jimbro1000/DragonATXProtoVDG/DragonATXProtoVDG.kicad_pcb

## KiCad design DragonATXProtoVDG.kicad_pcb (2025-12-16)

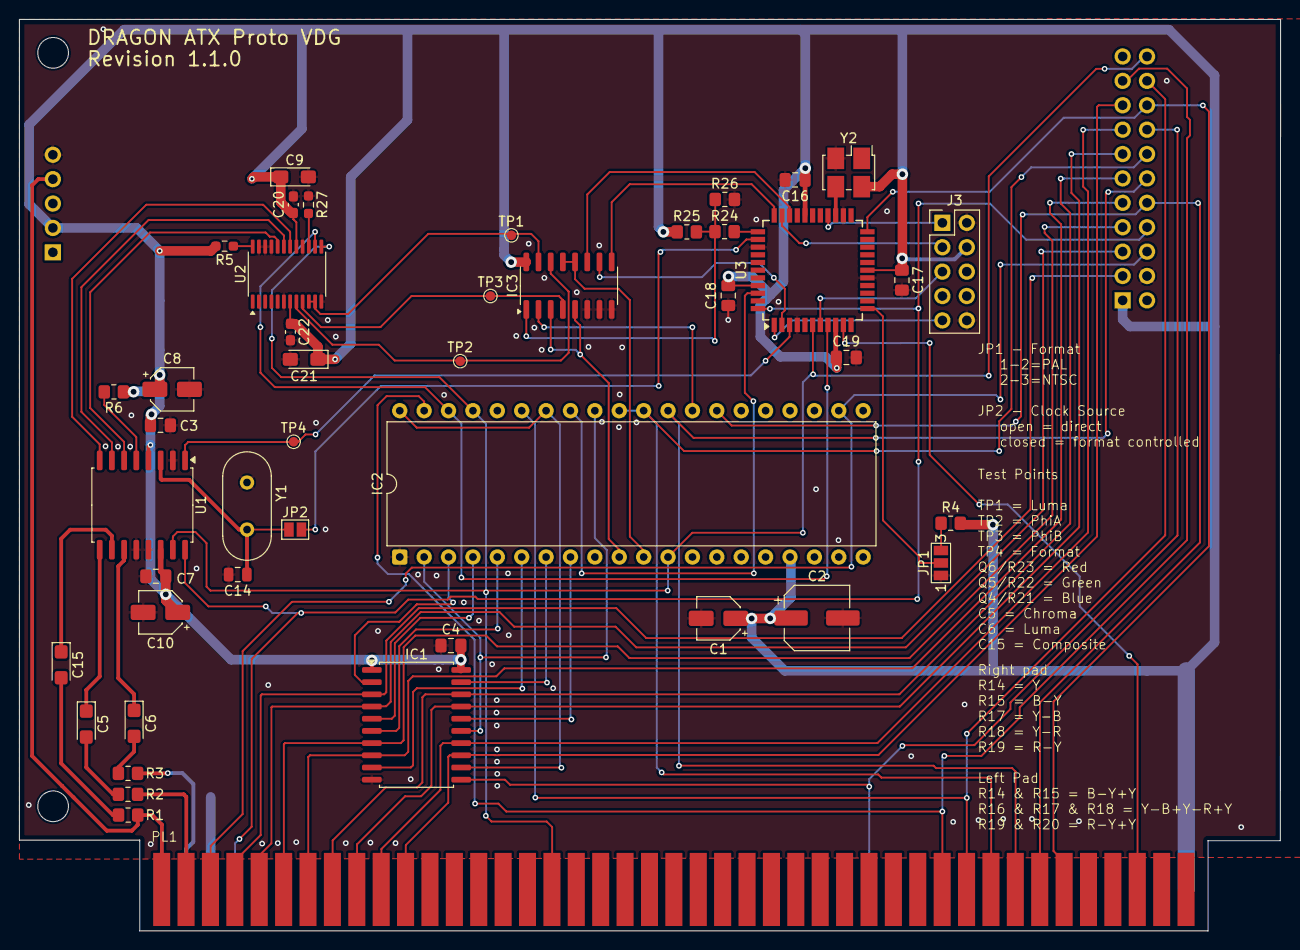
[picture p2: board DragonATXProtoVDG.kicad_pcb from above]

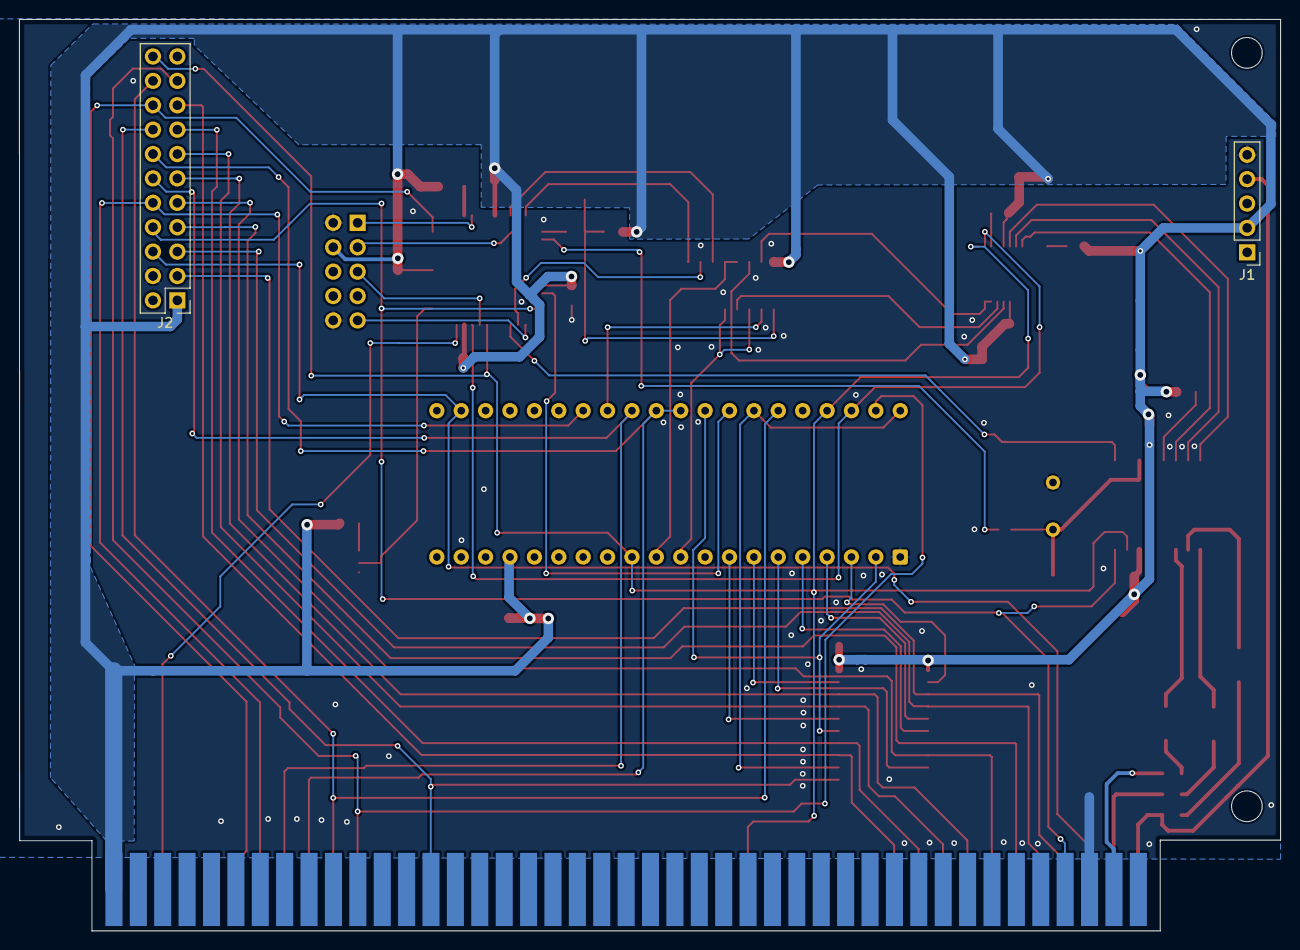
[picture p3: board DragonATXProtoVDG.kicad_pcb from below]

Board: 2 copper layers, 131.3 x 94.9 mm, 49 parts (2 on the bottom side), 67 nets.

Parts:
C1, C8, C10: 10uF; CP_Elec_4x5.4
C2: 100uF; CP_Elec_6.3x5.8
C3, C4, C7, C16, C17, C18, C19: 0.1uF; C_0805_2012Metric_Pad1.18x1.45mm_HandSolder
C5, C6, C15: 220uF; CP_EIA-3216-12_Kemet-S
C9, C21: 10uF; CP_EIA-3216-10_Kemet-I_Pad1.58x1.35mm_HandSolder
C14: 51pF; C_0805_2012Metric
C20, C22: 0.1uF; C_0603_1608Metric_Pad1.08x0.95mm_HandSolder
H1, H2: MountingHole; MountingHole_3.2mm_M3
IC1: 74LS273; SOIC-20W_7.5x12.8mm_P1.27mm
IC2: MC6847; DIP-40_W15.24mm
IC3: MC14053; SOIC-16_3.9x9.9mm_P1.27mm
J1: Video Output; PinHeader_1x05_P2.54mm_Vertical
J2: Board Interconnect Male; PinHeader_2x11_P2.54mm_Vertical
J3: JTAG; PinHeader_2x05_P2.54mm_Vertical
JP1: Video Format; SolderJumper-3_P1.3mm_Open_Pad1.0x1.5mm_NumberLabels
JP2: FormatClock; SolderJumper-2_P1.3mm_Open_Pad1.0x1.5mm
PL1: Card_Edge
R1, R2, R3: 75R; R_0805_2012Metric_Pad1.20x1.40mm_HandSolder
R4, R6: 10K; R_0805_2012Metric_Pad1.20x1.40mm_HandSolder
R5: 2k7; R_0603_1608Metric_Pad0.98x0.95mm_HandSolder
R24: 12K; R_0805_2012Metric_Pad1.20x1.40mm_HandSolder
R25: 8K2; R_0805_2012Metric_Pad1.20x1.40mm_HandSolder
R26: 1K8; R_0805_2012Metric_Pad1.20x1.40mm_HandSolder
R27: 10K; R_0603_1608Metric_Pad0.98x0.95mm_HandSolder
TP1: TestPoint_Luma; TestPoint_Pad_D1.0mm
TP2: TestPoint_PhiA; TestPoint_Pad_D1.0mm
TP3: TestPoint_PhiB; TestPoint_Pad_D1.0mm
TP4: TestPoint_FrameFormat; TestPoint_Pad_D1.0mm
U1: AD724JR; SOIC-16W_7.5x10.3mm_P1.27mm
U2: LMH1251; TSSOP-24_4.4x7.8mm_P0.65mm
U3: ATF1502ASL-xAx44; TQFP-44_10x10mm_P0.8mm
Y1: 4.433620MHz; Crystal_HC18-U_Vertical
Y2: 4.433618MHz; Oscillator_SMD_SeikoEpson_SG8002LB-4Pin_5.0x3.2mm_HandSolde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

Connections:
+5V: C1.1, C2.1, C3.1, C4.2, C7.2, C8.1, C9.1, C10.1, C16.1, C17.1, C18.1, C19.1, C20.2, C21.1, C22.1, IC1.1 (~Mr), IC1.20 (VCC), IC2.17 (VCC), IC3.16 (VDD), J1.2, J2.1, J3.4, PL1.b43, R4.2, R5.2, R6.1, R25.1, U1.4 (AVCC), U1.14 (DVCC), U2.7 (VCC), U2.17 (VCC), U3.9 (VCC), U3.17 (VCC), U3.29 (VCC), U3.41 (VCC), Y2.4 (Vdd)
/CSS: IC2.39 (CSS), J2.19, PL1.a33
/DA0: IC2.22 (DA0), J2.6, PL1.a3
/DL0: IC1.3 (D0), J2.3, PL1.a4
/DL1: IC1.4 (D1), J2.5, PL1.a5
/DL2: IC1.7 (D2), J2.7, PL1.a6
/DL3: IC1.8 (D3), J2.9, PL1.a7
/DL4: IC1.18 (D7), J2.11, PL1.a8
/DL5: IC1.17 (D6), J2.13, PL1.a9
/DL6: IC1.14 (D5), J2.15, PL1.a10
/DL7: IC1.13 (D4), J2.17, PL1.a11
/GM0: IC2.30 (GM0), IC2.31 (~INT/EXT), J2.14, PL1.a35
/GM1: IC2.29 (GM1), J2.12, PL1.a36
/GM2: IC2.27 (GM2), J2.10, PL1.a37
/HS: J2.8, PL1.b4, U1.16 (HSYNC), U3.44 (I/O)
/Q0: IC1.2 (Q0), IC2.3 (D0)
/Q1: IC1.5 (Q1), IC2.4 (D1)
/Q2: IC1.6 (Q2), IC2.5 (D2)
/Q3: IC1.9 (Q3), IC2.6 (D3)
/Q4: IC1.19 (Q7), IC2.7 (D4)
/Q5: IC1.16 (Q6), IC2.8 (D5)
/Q6: IC1.15 (Q5), IC2.2 (D6), IC2.32 (INV)
/Q7: IC1.12 (Q4), IC2.34 (~A/S), IC2.40 (D7)
/RAS: IC1.11 (Cp), J2.16, PL1.b30
/VCLK: J2.18, PL1.a38, U3.22 (I/O)
/~A/G: IC2.35 (~A/G), J2.20, PL1.a34
BLUE: U1.8 (BLUE), U2.18 (Bout)
CHROMA_CONTROL: IC3.9 (C), U3.33 (I/O)
CLK: IC2.33 (CLK), U3.42 (I/O)
Chroma: PL1.a2, R2.1
Composite: J1.4, PL1.a1, R1.1
E: PL1.a41, U3.10 (I/O)
FMT_CLOCK: JP2.2 (B), U3.35 (I/O/GCLK3)
Format: JP1.2 (C), U3.12 (I/O)
FrmFormat: TP4.1, U1.1 (NTSC/PAL), U3.3 (I/O)
GND: C1.2, C2.2, C3.2, C4.1, C7.1, C8.2, C9.2, C10.2, C14.2, C16.2, C17.2, C18.2, C19.2, C20.1, C21.2, C22.2, IC1.10 (GND), IC2.1 (GND), IC3.6 (INHIBIT), IC3.7 (VEE), IC3.8 (VSS), J1.5, J2.4, J3.2, J3.10, JP1.1 (A), PL1.b3, R26.2, R27.1, U1.2 (AGND), U1.12 (SELECT), U1.13 (DGND), U2.6 (GND), U2.12 (GND), U2.16 (GND), U2.21 (Sleep), U2.22 (SD/HD), U2.23 (AUTO), U3.4 (GND), U3.16 (GND), U3.24 (GND), U3.36 (GND), Y1.1, Y2.2 (GND)
GREEN: U1.7 (GREEN), U2.19 (Gout)
LUM: IC2.28 (Y), IC3.2 (Y0)
LUM CONTROL: IC3.10 (B), U3.2 (I/O)
LUM': IC3.15 (Y), TP1.1, U2.10 (Y), U2.11 (Ysync)
Luma: PL1.b2, R3.1
unnamed: C5.2, R2.2
unnamed: C6.2, R3.2
unnamed: C15.2, R1.2
unnamed: JP1.3 (B), R4.1
unnamed: C14.1, JP2.1 (A), U1.3 (4FSC_CLK), Y1.2
unnamed: R24.2, U3.34 (I/O)
unnamed: R6.2, U1.5 (CE)
unnamed: C5.1, U1.9 (CHROM_OUT)
unnamed: C15.1, U1.10 (CVBS_OUT)
unnamed: C6.1, U1.11 (LUM_OUT)
unnamed: R27.2, U2.15 (Rext)
unnamed: R5.1, U2.24 (Select)
PALClock: U3.25 (I/O), Y2.3 (OUT)
PadLuma: IC3.1 (Y1), R24.1, R25.2, R26.1
RED: U1.6 (RED), U2.20 (Rout)
SYNC_CONTROL: IC3.11 (A), U3.31 (I/O)
TCK: J3.1, U3.26 (I/O/TCK)
TDI: J3.9, U3.1 (I/O/TDI)
TDO: J3.3, U3.32 (I/O/TDO)
TMS: J3.5, U3.7 (I/O/TMS)
phiA: IC2.11 (A), IC3.12 (X0), IC3.13 (X1)
phiA': IC3.14 (X), TP2.1, U2.8 (PRin)
phiB: IC2.10 (B), IC3.3 (Z1), IC3.5 (Z0)
phiB': IC3.4 (Z), TP3.1, U2.9 (PBin)
~FS: IC2.12 (~MS), IC2.37 (~FS), J2.22, PL1.a17, U1.15 (VSYNC), U2.13 (VSout), U3.6 (I/O)
~HS: IC2.38 (~HS), U2.14 (HSout), U3.8 (I/O)
