jimbro1000/DragonATXProtoVDG/(commit log)

2025-03-19 upgrade card edge spec
    [DragonATXProtoVDG.kicad_pcb]
2025-03-24 prepare for fabrication
    [DragonATXProtoVDG.kicad_pcb]
2025-06-02 refine design for ATF1504
    [DragonATXProtoVDG.kicad_pcb, DragonATXProtoVDG.kicad_sch]
2025-06-03 update board render
    [DragonATXProtoVDG.kicad_pcb]
2025-06-03 rework for path gates
    [DragonATXProtoVDG.kicad_pcb, DragonATXProtoVDG.kicad_sch]
2025-06-04 swap to larger CPLD
    [DragonATXProtoVDG.kicad_pcb, DragonATXProtoVDG.kicad_sch]
2025-06-04 revert accidental changes
    [DragonATXProtoVDG.kicad_pcb, DragonATXProtoVDG.kicad_sch]
